DmitryMuravyev/ATtiny10-DS18B20-Fan-Controller/Device_Image.jpg

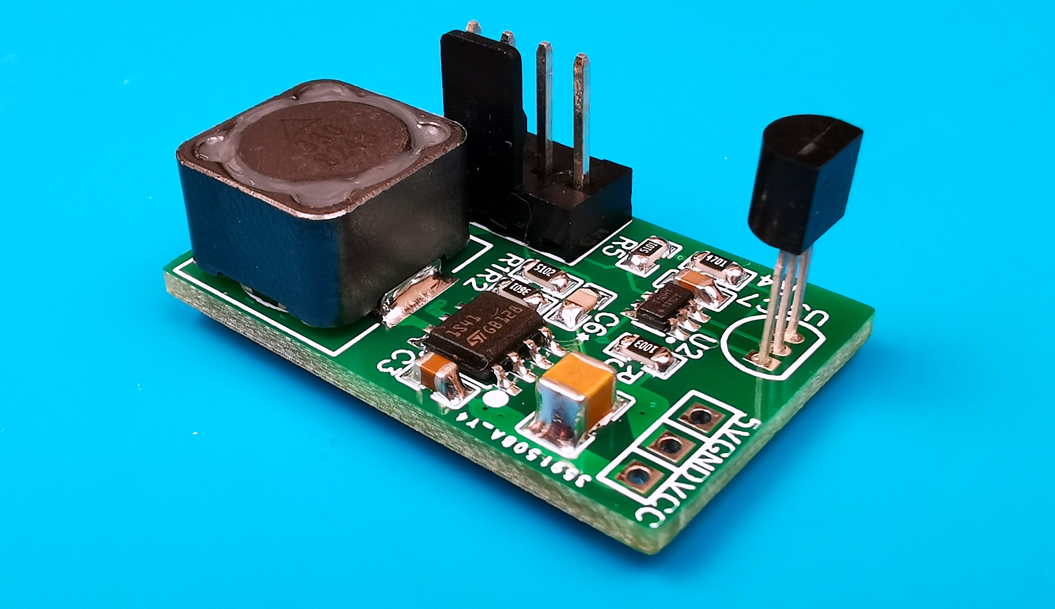
Device_Image.jpg
